swewalka/FIRST-Space-Team-project/launch-checklist.md

# Launch Checklist

## 1. Assembly

| Done | Index | Task | Tools / Materials |
|:---:|:---:|---|---|
| [ ] | 1.1 | Mount upper and lower rail buttons | 2x M3x10 screws, Torx key set |
| [ ] | 1.2 | Mount flight computer onto electronics mount | 2x M3x8 screws, Torx key set |
| [ ] | 1.3 | Mount battery onto electronics mount | Tape |
| [ ] | 1.4 | Mount RBF pin mechanism into electronics segment | — |
| [ ] | 1.5 | Mount electronics mount into E-Bay | 3x M3x8 screws, Torx key set |
| [ ] | 1.6 | Insert RBF safety pin | RBF pin |
| [ ] | 1.7 | Prepare payload: 3 eggs | 3 eggs |
| [ ] | 1.8 | Put dampening foam into cone | Dampening foam |
| [ ] | 1.9 | Insert payload into cone | — |
| [ ] | 1.10 | Make sure payload sits tight | — |
| [ ] | 1.11 | Mount nose cone | — |
| [ ] | 1.12 | Connect lower body tube with friction coupler | — |
| [ ] | 1.13 | Check and, if necessary, fix friction fit | Tape |
| [ ] | 1.14 | Screw in boat tail and check for fit | — |

## 2. Launch Preparation

| Done | Index | Task | Tools / Materials |
|:---:|:---:|---|---|
| [ ] | 2.1 | Make sure all rocket parts are properly assembled | — |
| [ ] | 2.2 | Remove electronics mount | Torx key set |
| [ ] | 2.3 | Connect flight computer to battery | — |
| [ ] | 2.4 | Verify flight computer functionality | — |
| [ ] | 2.5 | Notify launch officers and wait for preparation of black powder charge | — |
| [ ] | 2.6 | Mount electronics mount into E-Bay | 3x M3x10 screws, Torx key set |
| [ ] | 2.7 | Insert RBF safety pin and verify it is fully seated | RBF pin |
| [ ] | 2.8 | Connect black powder charge to flight computer with RBF safety pin inserted | — |
| [ ] | 2.9 | Wrap parachute in Kevlar cloth | — |
| [ ] | 2.10 | Put parachute and black powder charge into recovery compartment | — |
| [ ] | 2.11 | Verify that the parachute does not get stuck in the rocket | — |
| [ ] | 2.12 | Wait for motor preparation | — |
| [ ] | 2.13 | Insert motor into motor tube | — |
| [ ] | 2.14 | Screw boat tail on | — |
| [ ] | 2.15 | Check the rocket for any obvious faults | — |
| [ ] | 2.16 | Notify launch officers that the rocket is ready for launch | — |

## 3. Launch Pad

| Done | Index | Task | Tools / Materials |
|:---:|:---:|---|---|
| [ ] | 3.1 | Remove RBF safety pin to power on flight computer | RBF pin |
