swewalka/FIRST-Space-Team-project/3d models/CNCKitchen_Inserts_2025-07/STEP/14-20.step

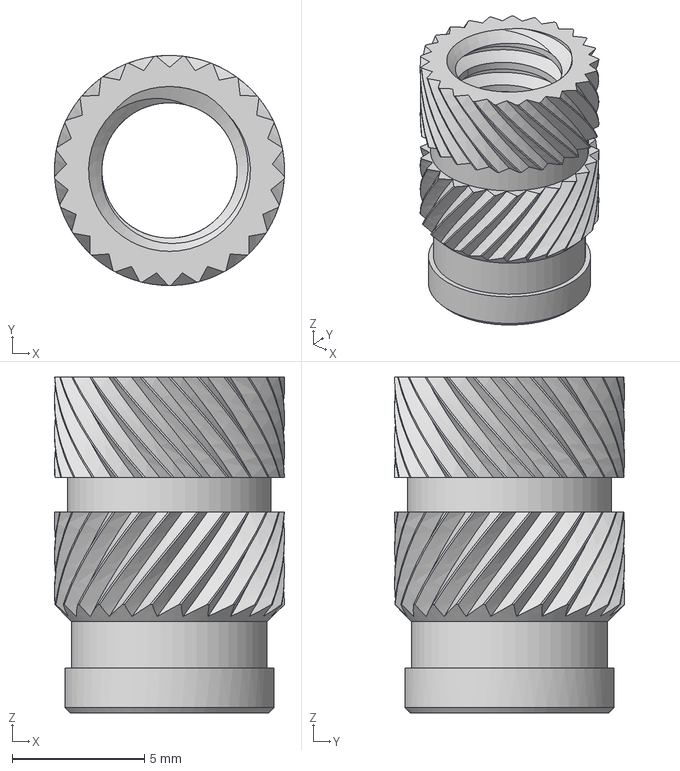
[picture p1: CAD file, 2026-10-09]
3d models/CNCKitchen_Inserts_2025-07/STEP/14-20.step
8.70 x 8.70 x 12.7 mm
