swewalka/FIRST-Space-Team-project/3d models/CNCKitchen_Inserts_2025-07/STL/m3_standard.stl

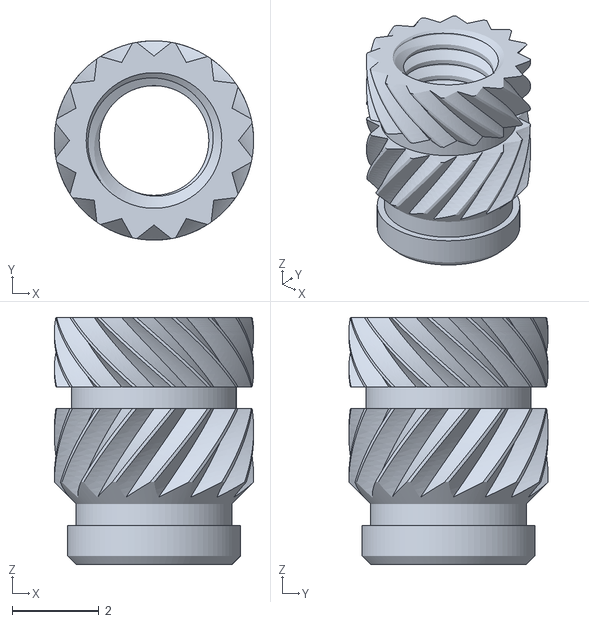
[picture p2: CAD file, 2026-10-09]
3d models/CNCKitchen_Inserts_2025-07/STL/m3_standard.stl
4.60 x 4.60 x 5.70
