swewalka/FIRST-Space-Team-project/3d models/RBF Pin.step

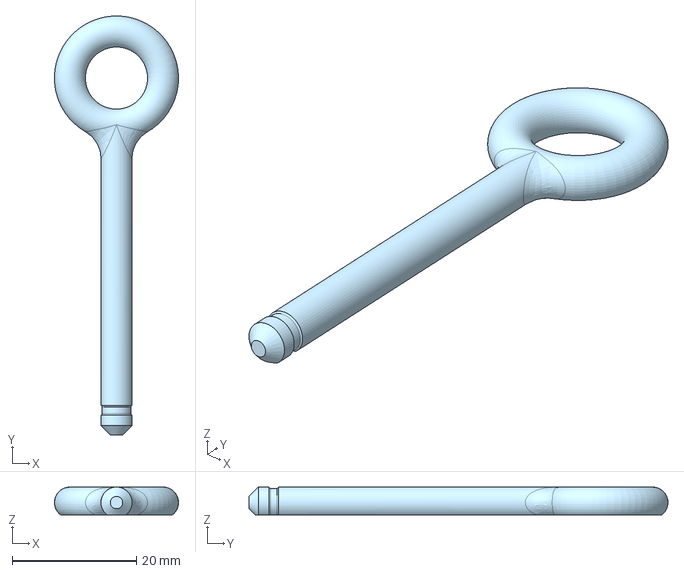
[picture p3: CAD file, 2026-11-08]
3d models/RBF Pin.step
20.0 x 67.5 x 4.50 mm
