swewalka/FIRST-Space-Team-project/3d models/Avionics Plate V3.step

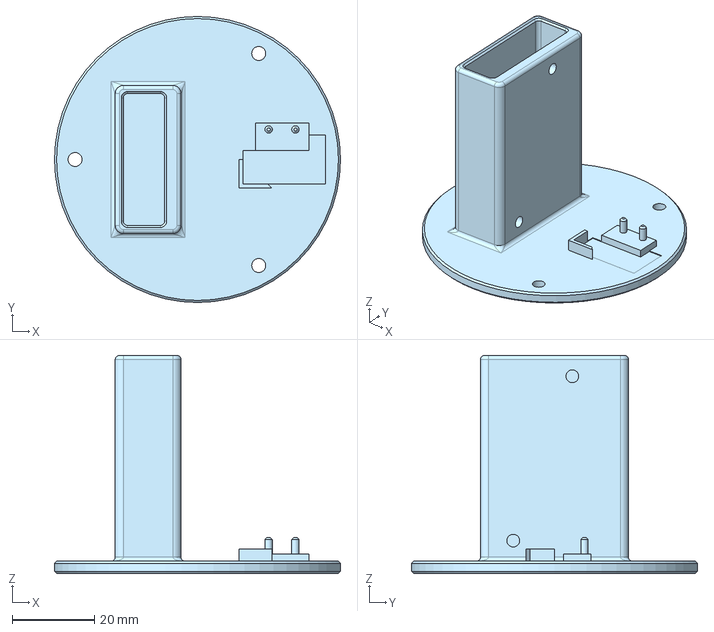
[picture p4: CAD file, 2026-11-08]
3d models/Avionics Plate V3.step
69.5 x 69.5 x 53.0 mm
