swewalka/FIRST-Space-Team-project/3d models/CNCKitchen_Inserts_2025-07/STEP/m4_short.step

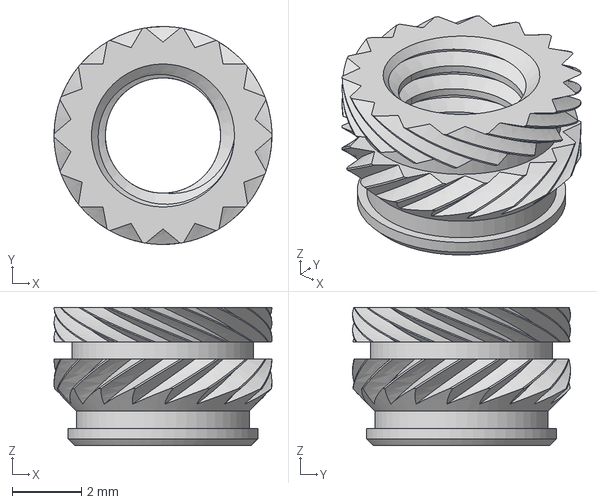
[picture p5: CAD file, 2026-10-09]
3d models/CNCKitchen_Inserts_2025-07/STEP/m4_short.step
6.30 x 6.30 x 4.00 mm
