swewalka/FIRST-Space-Team-project/3d models/CNCKitchen_Inserts_2025-07/STL/m4_standard.stl

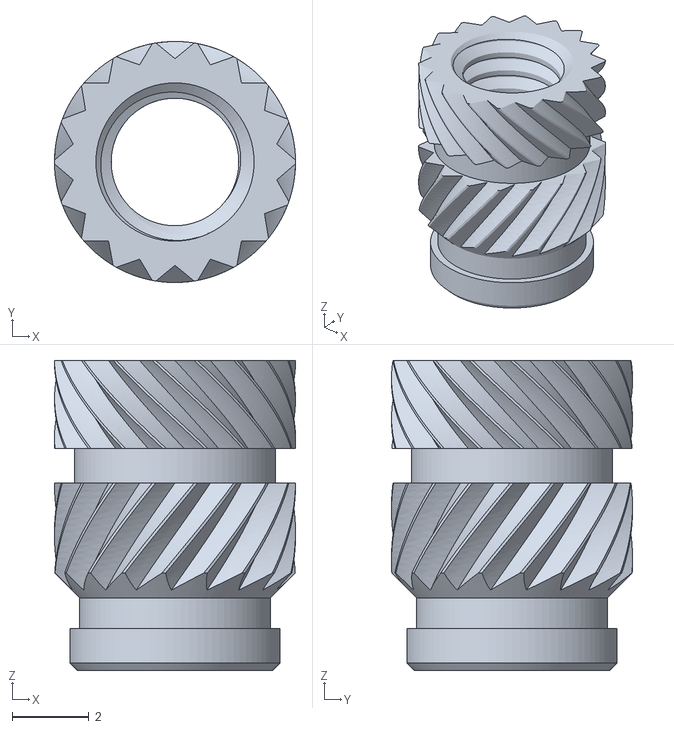
[picture p6: CAD file, 2026-10-09]
3d models/CNCKitchen_Inserts_2025-07/STL/m4_standard.stl
6.30 x 6.30 x 8.10
