swewalka/FIRST-Space-Team-project/3d models/CNCKitchen_Inserts_2025-07/STL/m3_short.stl

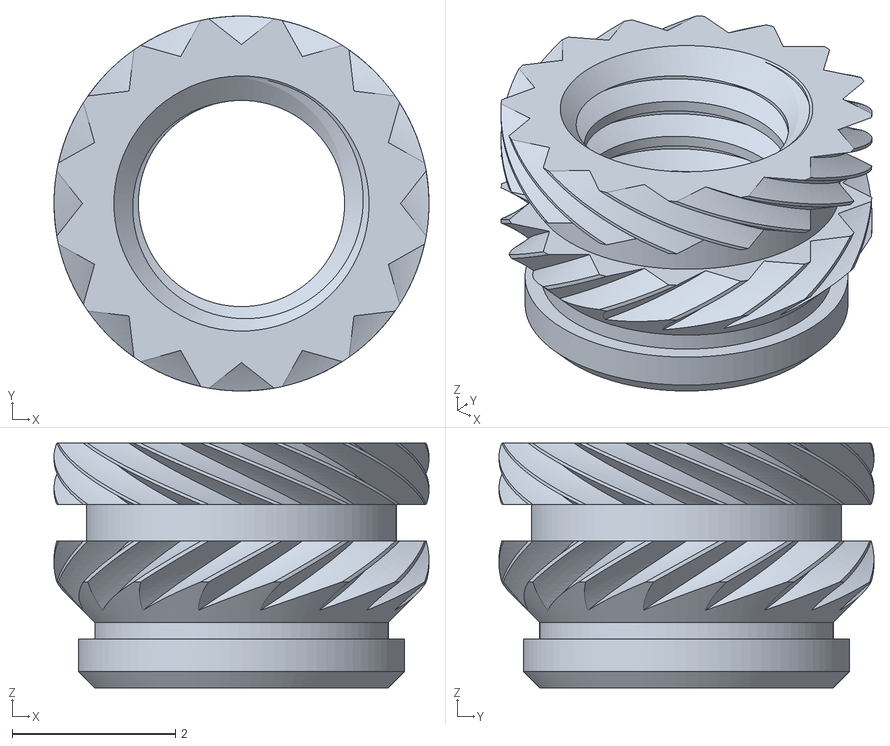
[picture p7: CAD file, 2026-10-09]
3d models/CNCKitchen_Inserts_2025-07/STL/m3_short.stl
4.60 x 4.60 x 3.00
