swewalka/FIRST-Space-Team-project/3d models/RBF Box.step

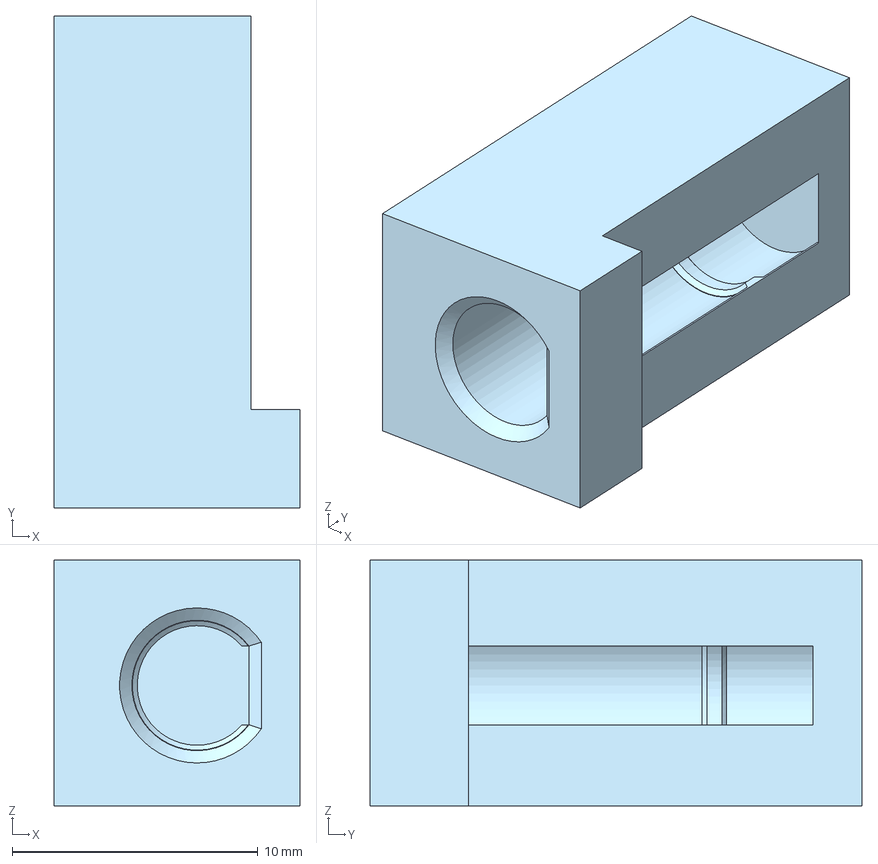
[picture p8: CAD file, 2026-11-08]
3d models/RBF Box.step
10.0 x 20.0 x 10.0 mm
