swewalka/FIRST-Space-Team-project/3d models/CNCKitchen_Inserts_2025-07/STEP/m2p5_short.step

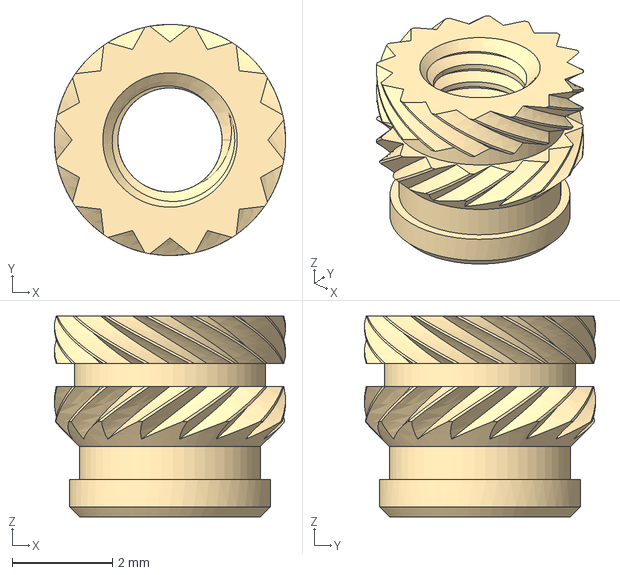
[picture p9: CAD file, 2026-10-09]
3d models/CNCKitchen_Inserts_2025-07/STEP/m2p5_short.step
4.60 x 4.60 x 4.00 mm
