swewalka/FIRST-Space-Team-project/3d models/Fin Can.step

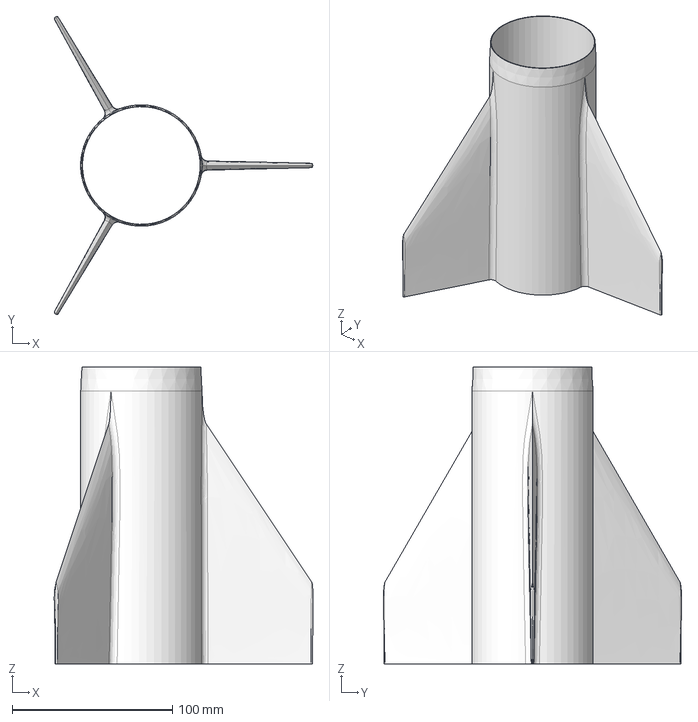
[picture p10: CAD file, 2026-11-08]
3d models/Fin Can.step
161.1 x 185.7 x 185.0 mm
