swewalka/FIRST-Space-Team-project/3d models/CNCKitchen_Inserts_2025-07/STEP/m5_short.step

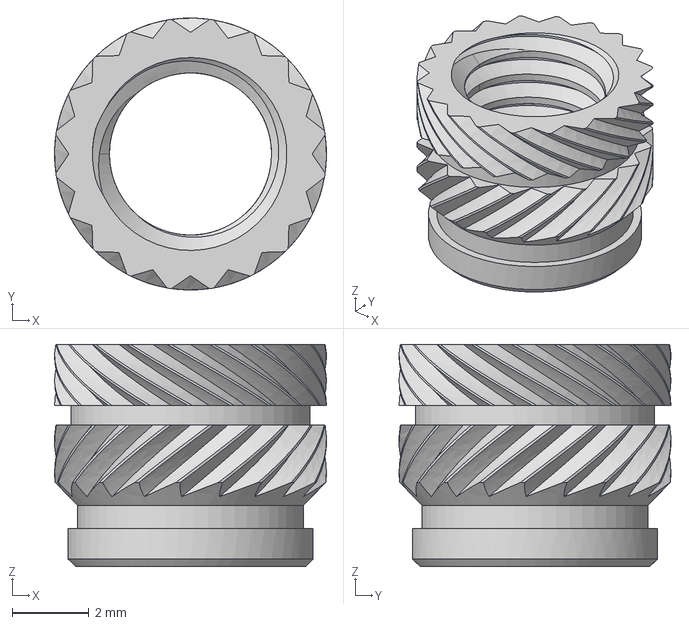
[picture p11: CAD file, 2026-10-09]
3d models/CNCKitchen_Inserts_2025-07/STEP/m5_short.step
7.10 x 7.10 x 5.80 mm
