swewalka/FIRST-Space-Team-project/3d models/Lower Attachment Ring.step

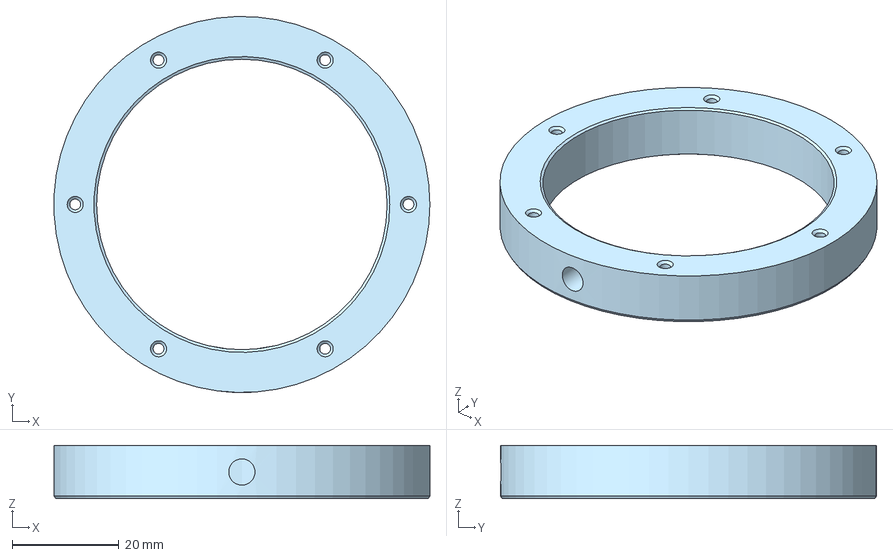
[picture p12: CAD file, 2026-11-08]
3d models/Lower Attachment Ring.step
70.3 x 70.3 x 10.0 mm
