swewalka/FIRST-Space-Team-project/3d models/CNCKitchen_Inserts_2025-07/STEP/g18-28_standard.step

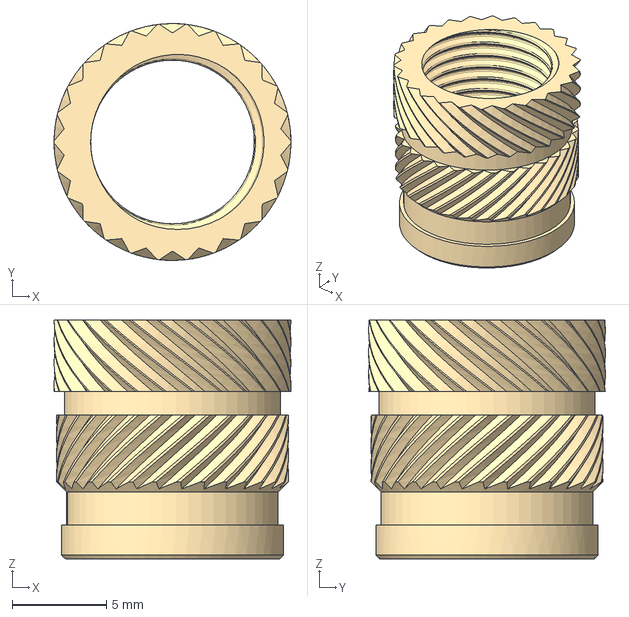
[picture p13: CAD file, 2026-10-09]
3d models/CNCKitchen_Inserts_2025-07/STEP/g18-28_standard.step
12.6 x 12.6 x 12.7 mm
