swewalka/FIRST-Space-Team-project/3d models/Upper Attachment Ring.step

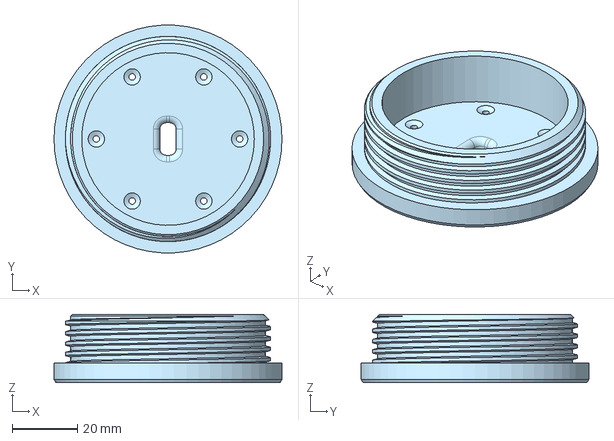
[picture p14: CAD file, 2026-11-08]
3d models/Upper Attachment Ring.step
70.0 x 69.9 x 21.0 mm
