swewalka/FIRST-Space-Team-project/3d models/Boat Tail Internal Thread.step

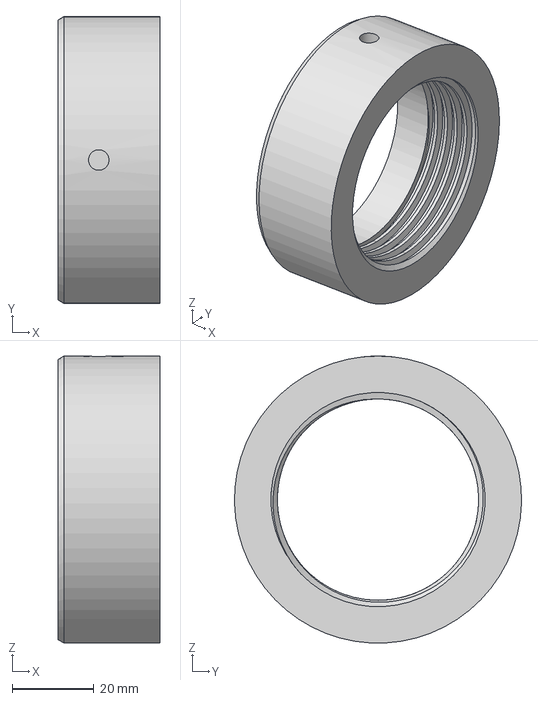
[picture p15: CAD file, 2026-11-08]
3d models/Boat Tail Internal Thread.step
25.0 x 70.1 x 70.1 mm
