swewalka/FIRST-Space-Team-project/3d models/CNCKitchen_Inserts_2025-07/STEP/m8_standard.step

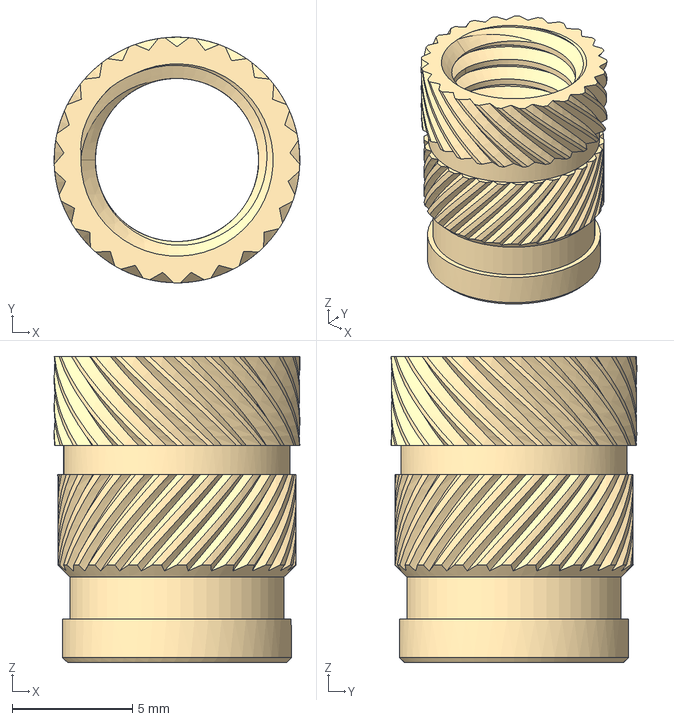
[picture p16: CAD file, 2026-10-09]
3d models/CNCKitchen_Inserts_2025-07/STEP/m8_standard.step
10.2 x 10.2 x 12.7 mm
