swewalka/FIRST-Space-Team-project/3d models/Boat Tail External Thread.step

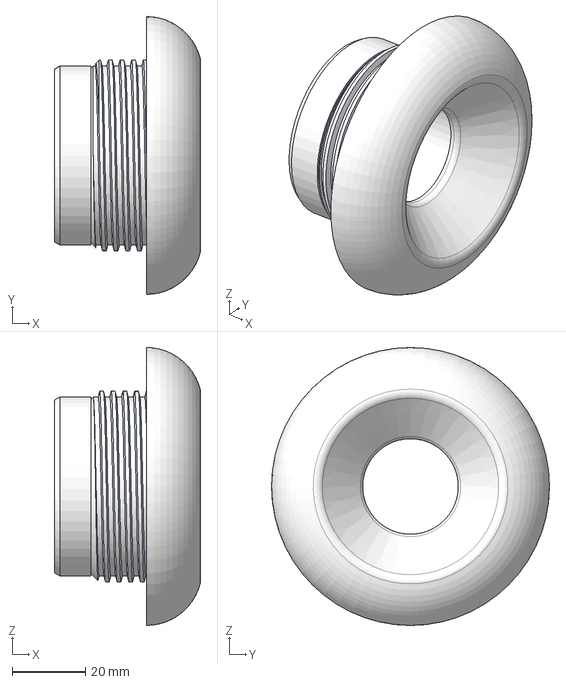
[picture p17: CAD file, 2026-11-08]
3d models/Boat Tail External Thread.step
39.8 x 75.7 x 75.7 mm
