swewalka/FIRST-Space-Team-project/3d models/CNCKitchen_Inserts_2025-07/STEP/m5_standard.step

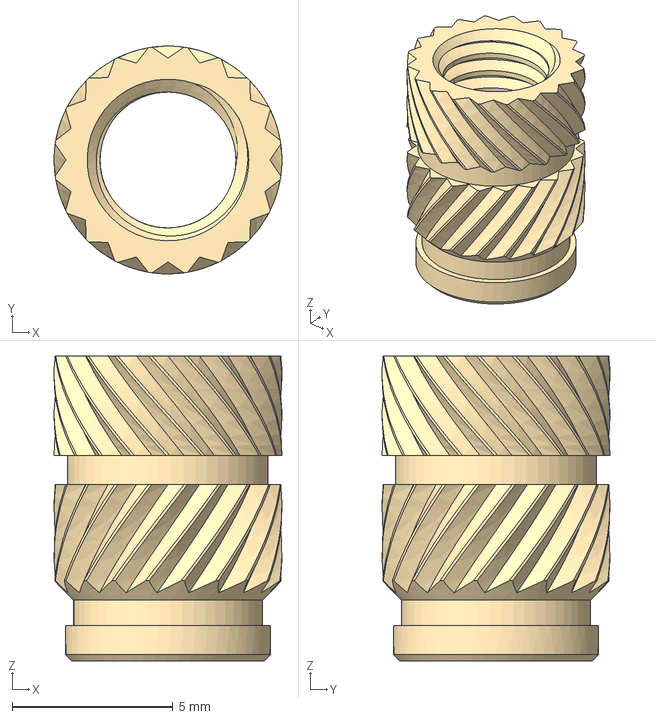
[picture p18: CAD file, 2026-10-09]
3d models/CNCKitchen_Inserts_2025-07/STEP/m5_standard.step
7.10 x 7.10 x 9.50 mm
