swewalka/FIRST-Space-Team-project/3d models/Elliptical Cone.step

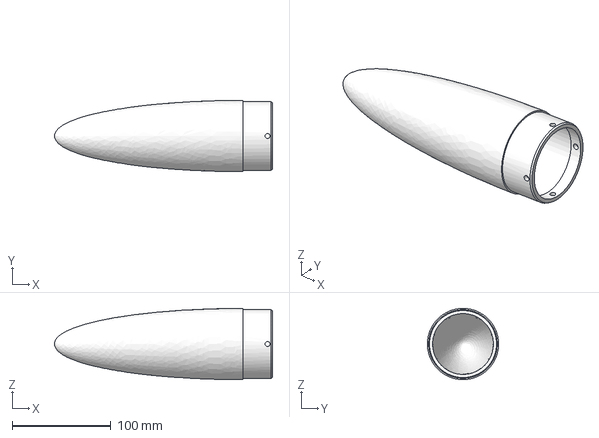
[picture p19: CAD file, 2026-11-08]
3d models/Elliptical Cone.step
221.3 x 72.4 x 72.4 mm
