swewalka/FIRST-Space-Team-project/3d models/Print File.3mf

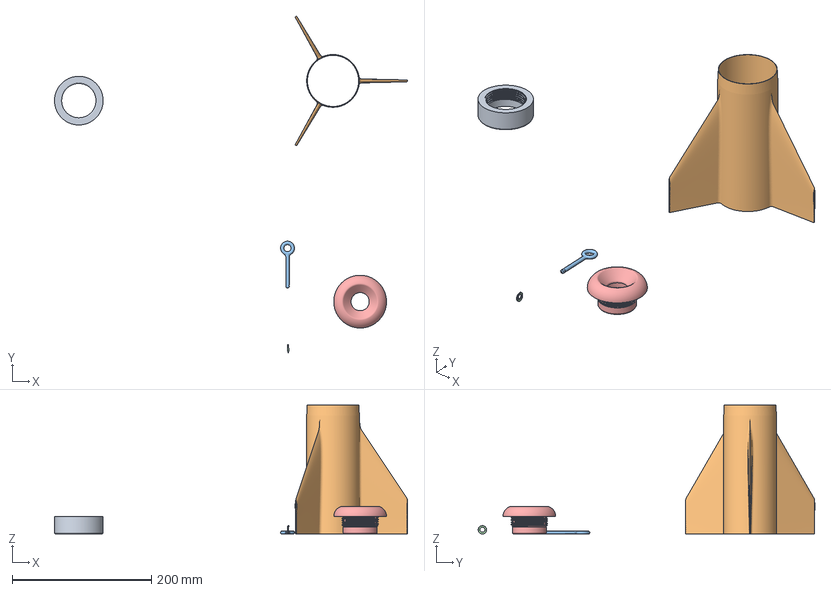
[picture p20: CAD file, 2026-11-08]
3d models/Print File.3mf
506.5 x 483.0 x 185.0 mm
Boat Tail - innengewinde.step
Fin_Can_1 - fin_tube.step
RBF Pin - RBF Pin.step
safety pin slot.step
Boat Tail - außengewinde.step
