swewalka/FIRST-Space-Team-project/3d models/Safety Pin Slot.step

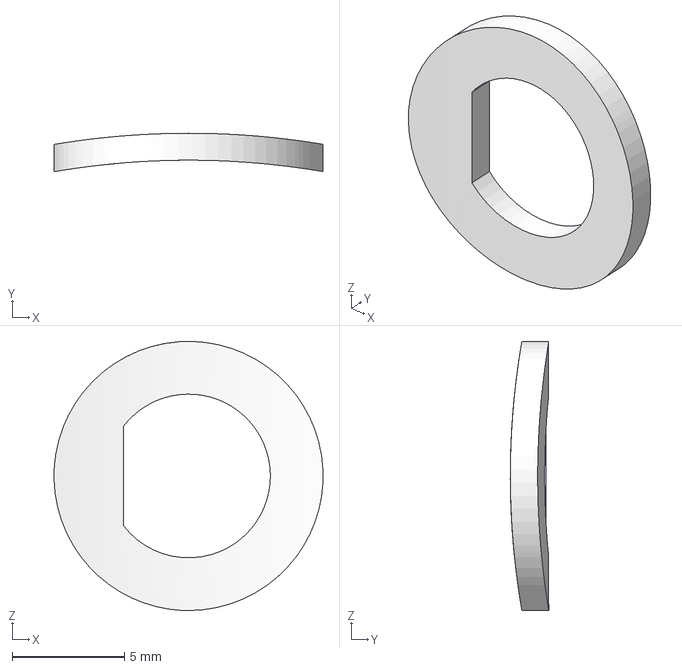
[picture p21: CAD file, 2026-11-08]
3d models/Safety Pin Slot.step
12.0 x 1.72 x 12.0 mm
