swewalka/FIRST-Space-Team-project/3d models/Coupler Tube V3.step

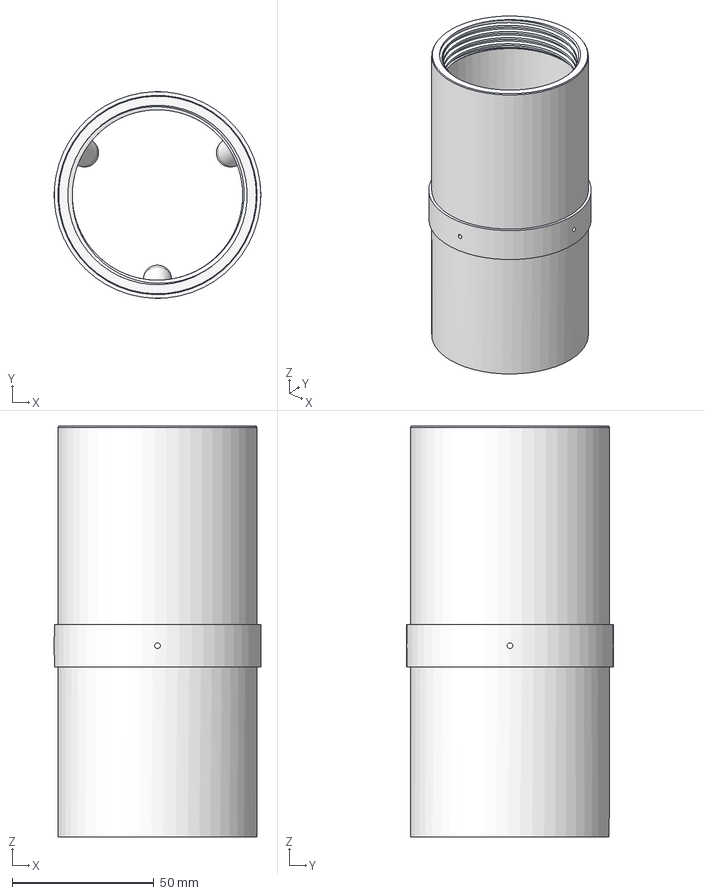
[picture p22: CAD file, 2026-11-08]
3d models/Coupler Tube V3.step
72.9 x 72.9 x 145.0 mm
