swewalka/FIRST-Space-Team-project/3d models/Drill Guide 4mm.step

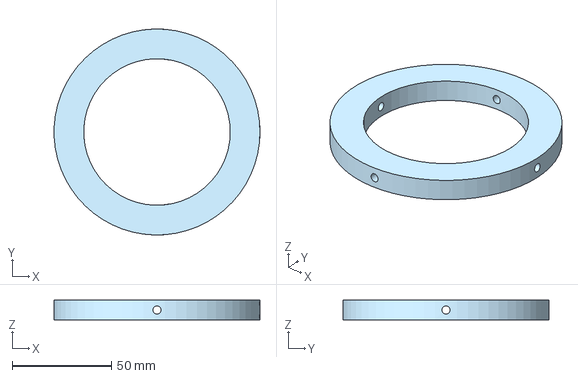
[picture p23: CAD file, 2026-11-08]
3d models/Drill Guide 4mm.step
103.9 x 103.9 x 10.0 mm
