swewalka/FIRST-Space-Team-project/3d models/RBF Box - RBF Box.step

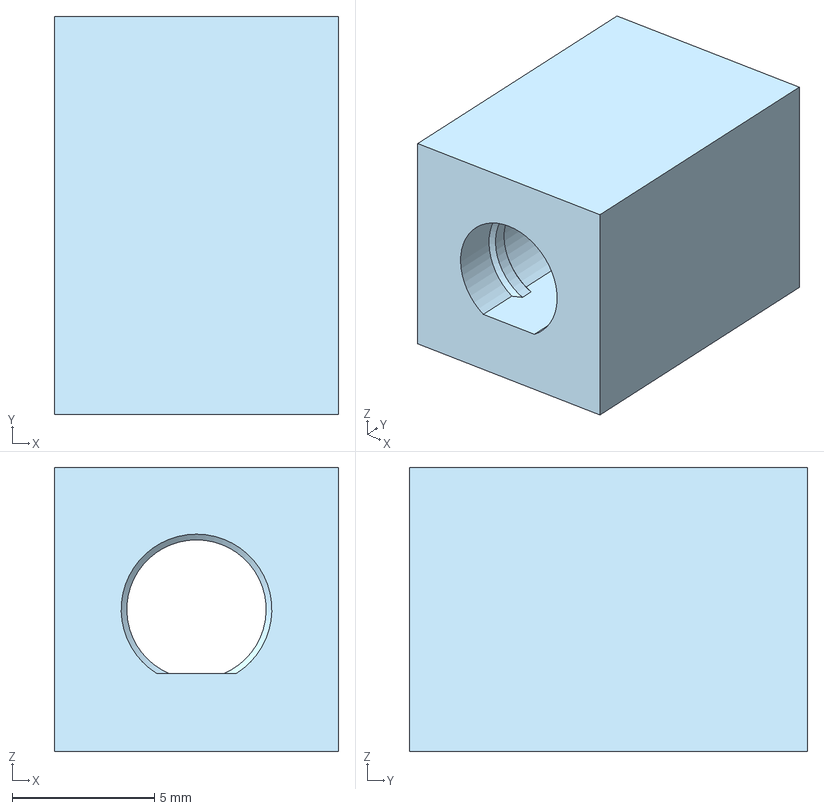
[picture p24: CAD file, 2026-10-09]
3d models/RBF Box - RBF Box.step
10.0 x 14.0 x 10.0 mm
