swewalka/FIRST-Space-Team-project/3d models/Coupler_Tube_V2 - Coupler_Tube.step

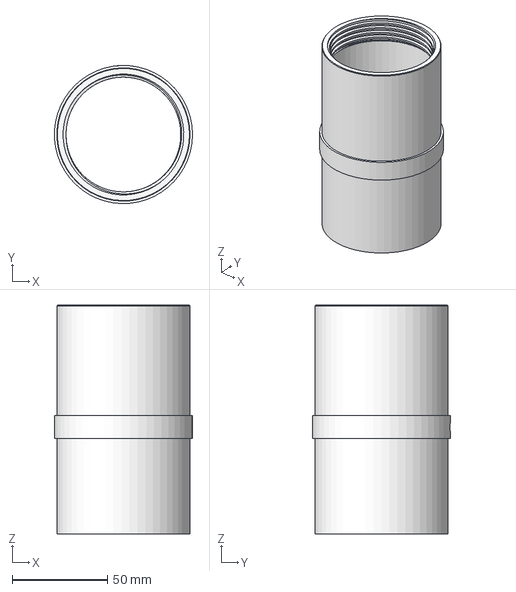
[picture p25: CAD file, 2026-10-09]
3d models/Coupler_Tube_V2 - Coupler_Tube.step
72.3 x 72.4 x 120.0 mm
