swewalka/FIRST-Space-Team-project/3d models/RBF Pin - RBF Pin.step

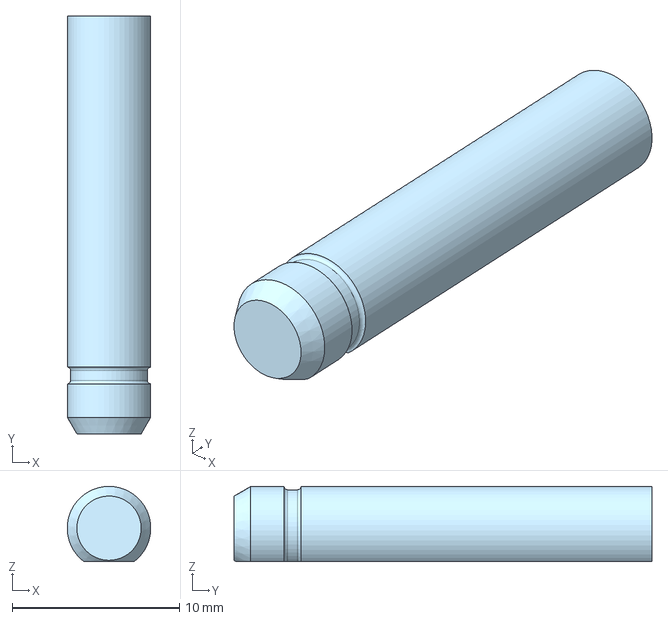
[picture p26: CAD file, 2026-10-09]
3d models/RBF Pin - RBF Pin.step
4.99 x 25.0 x 4.50 mm
