swewalka/FIRST-Space-Team-project/3d models/Avionics_Plate_V2 - Aviontics Plate.step

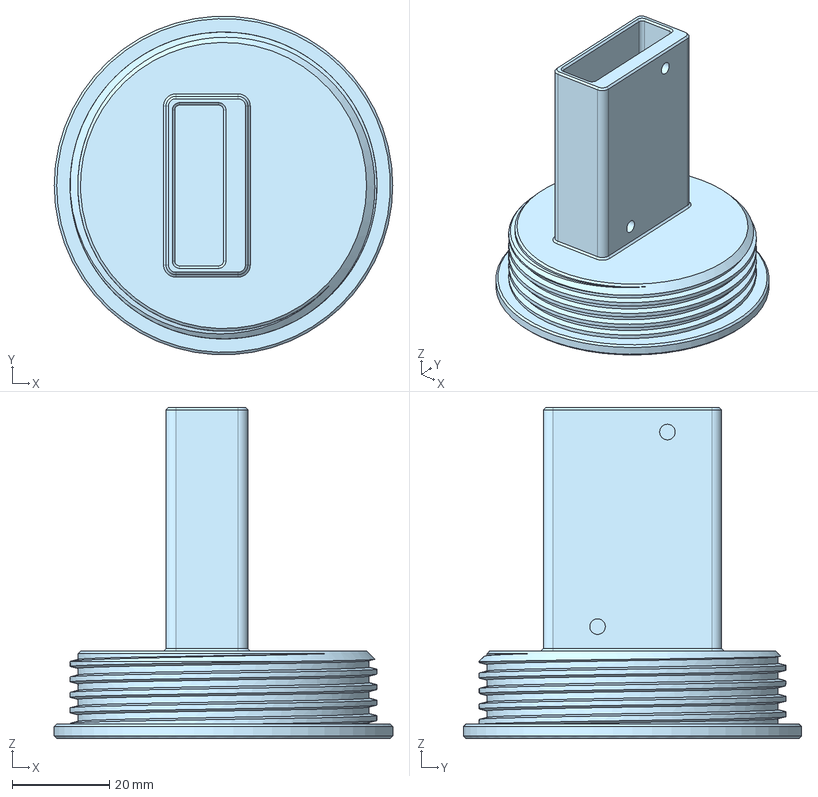
[picture p27: CAD file, 2026-10-09]
3d models/Avionics_Plate_V2 - Aviontics Plate.step
69.5 x 69.4 x 68.0 mm
