swewalka/FIRST-Space-Team-project/(list of files, cad)

Other CAD files:
3d models/CNCKitchen_Inserts_2025-07/STEP/m6_standard.step
3d models/CNCKitchen_Inserts_2025-07/STL/14-20_standard.stl
3d models/CNCKitchen_Inserts_2025-07/STEP/m10_standard.step
3d models/Fin_Can_1 - fin_tube.step
3d models/Boat Tail - außengewinde.step
3d models/Boat Tail - innengewinde.step
3d models/Boat Tail - innengewinde.3mf
3d models/CNCKitchen_Inserts_2025-07/STL/g18-28_standard.stl
3d models/CNCKitchen_Inserts_2025-07/STL/m10_standard.stl
3d models/CNCKitchen_Inserts_2025-07/STL/m2p5_short.stl
3d models/CNCKitchen_Inserts_2025-07/STL/m4_short.stl
3d models/CNCKitchen_Inserts_2025-07/STL/m5_short.stl
3d models/CNCKitchen_Inserts_2025-07/STL/m5_standard.stl
3d models/CNCKitchen_Inserts_2025-07/STL/m6_standard.stl
3d models/CNCKitchen_Inserts_2025-07/STL/m8_standard.stl
3d models/RBF Pin - v2.step
3d models/printfile.3mf
