swewalka/FIRST-Space-Team-project/guidelines/how-to-rocketry-UoF.pdf

Link to workshops from previous FIRST seasons: https://youtube.com/playlist?list=PLF_iJ5FHlMIT2lomy2YwLGfMxNMTDnl-G

1Fins

1.1Use fillets at edges between bodytube and fins
1.2When slotting fins into the bodytube, do not cut the bodytube all the way to the end -this leads to structural weaknesses
1.3Be careful when fins protrude behind the bodytube - this can cause fins to break upon ground impact. Fins can be designed as replaceable to avoid this issue. 1.4Aerodynamic stability can be increased with spin, although it's not very usual due to the increased manufacturing complexity.
2Motor mount

2.1The motor casing has to be easily integrable and removable from the rocket.

# How to Rocketry

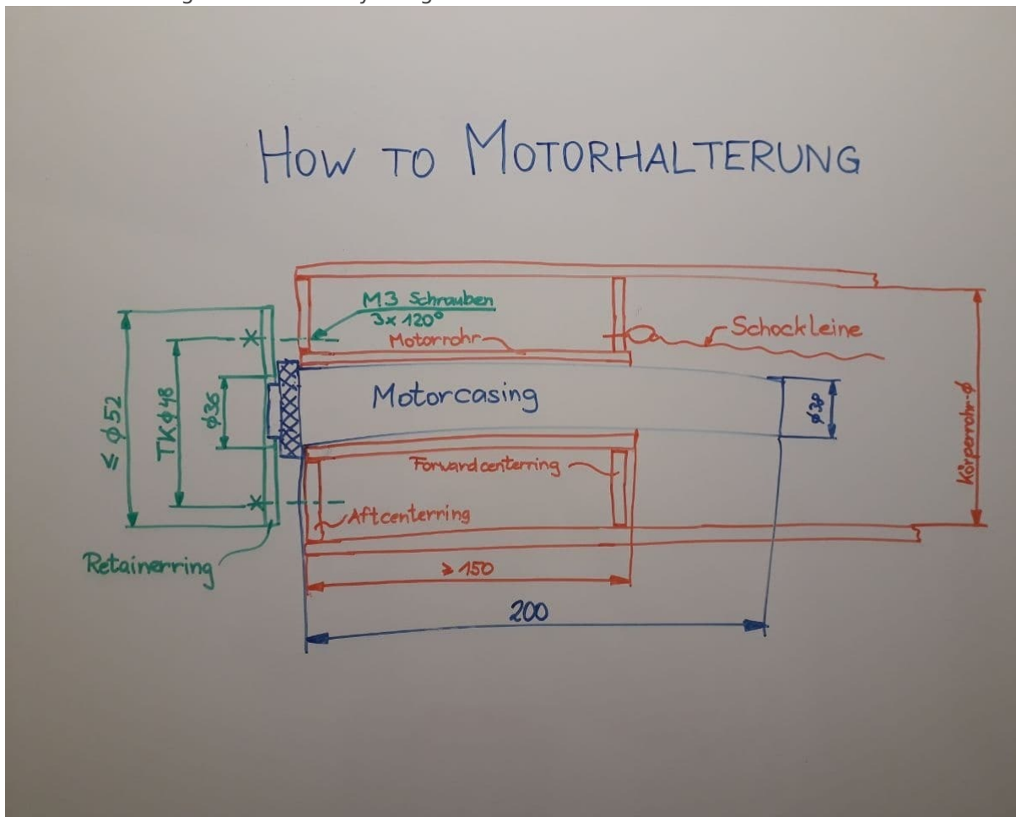
[picture p28: figure]

2.2The motor casing has to be held inside the motor tube, usually with a retainer ring or a threaded tailcone.
2.3Make sure that no screws or retainer parts protrude unnecessarily far behind the body tube.
2.4Nomenklatur:

2.4.1Grain: solid fuel/oxidator mixture, that gets burned and prodruces the thrust 2.4.2Reload: consists of grains and other single use parts, that can be bought as a package (e.g. Aerotech H2389T)
2.4.3Motorcasing: reusable metal casing that holds the grain - it's classified by their diamter and length in millimeters (e.g. 29/180)
2.4.4Motorrohr/Motorhalter: tube (often cardboard) that is fixed inside the back of the rocket, in which the motor casing can be inserted and fixed
2.4.5Adapter: can be used to put smaller motor casings into motor mounts with a larger diameter, e.g. using a 29 mm motor casing in a 38 mm motor mount 2.4.6Retainer: hold the motor casing inside the motor tube
2.4.7Spacer: allows using casings, that would normally require a more powerful motor, with a smaller one by replacing grains with spacers
3Motor

3.1We usually use a Aerotech H-238T with a RMS-29/180 casing or a RMS-29/240 casing with one spacer. The image shows a section cut of an Aerotech H220T motor.

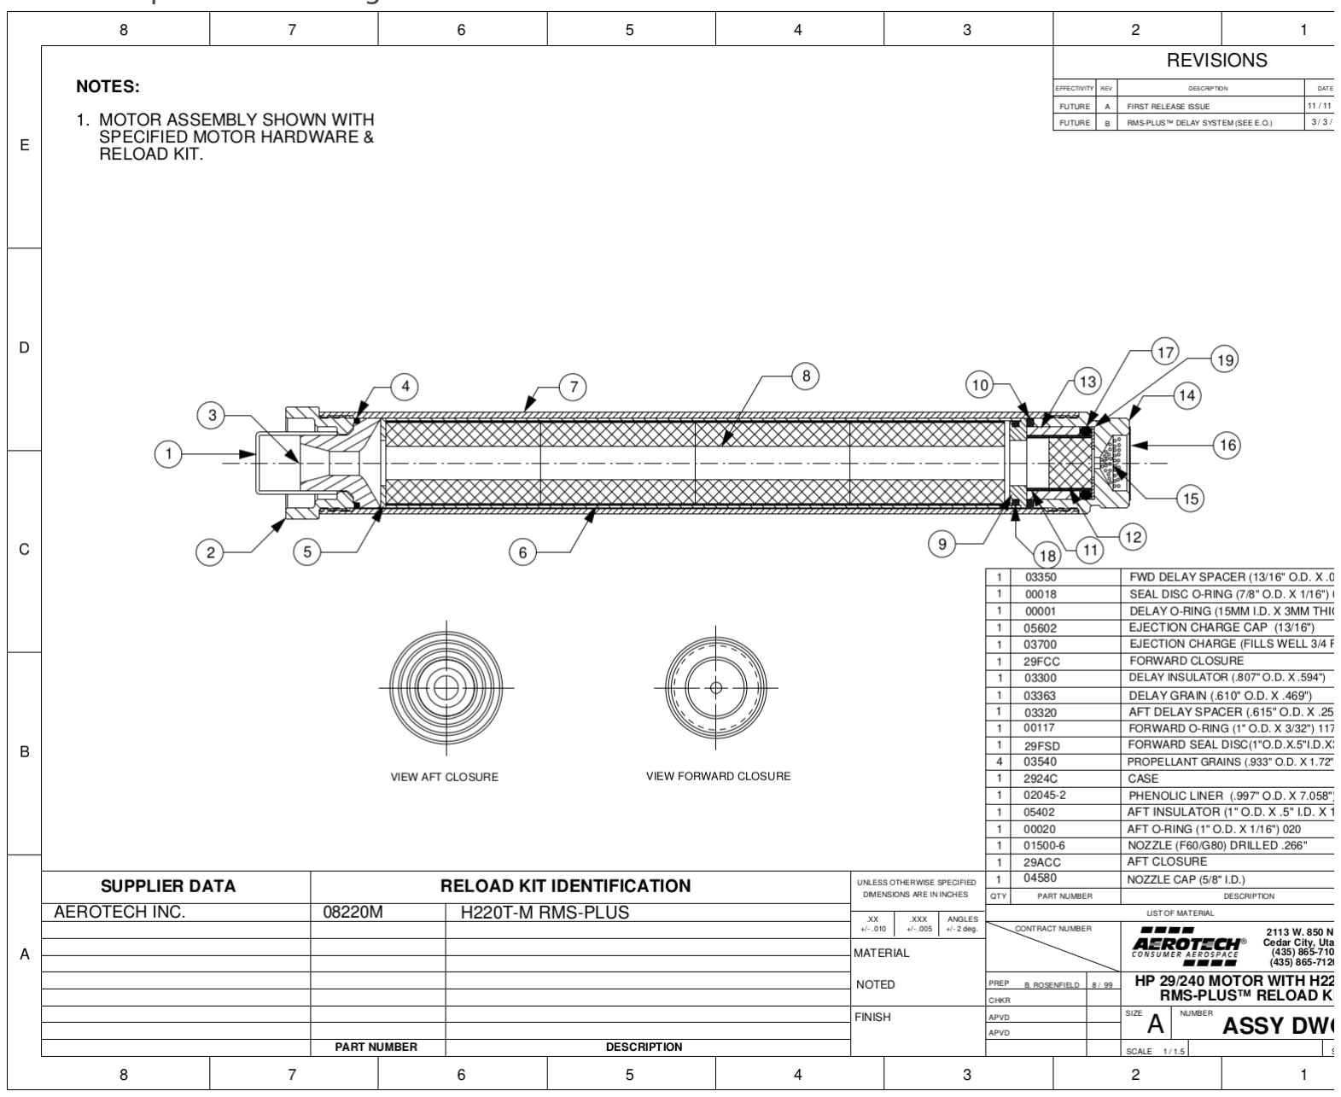
[picture p29: figure]

4Railbuttons

4.1one should be placed far back on the rocket, so that the rockets remains guided in the launch rail for as long as possible, while the other one should be located around the rocket's center of mass
4.2if the railbuttons are placed on seperate body tube segments, they should be designed to prevent rotation between the two bodytube segments
4.3the mount of the railbuttons on the inside of the rocket must not obstruct the parachute from deploying
4.4measurements of the railbutton:

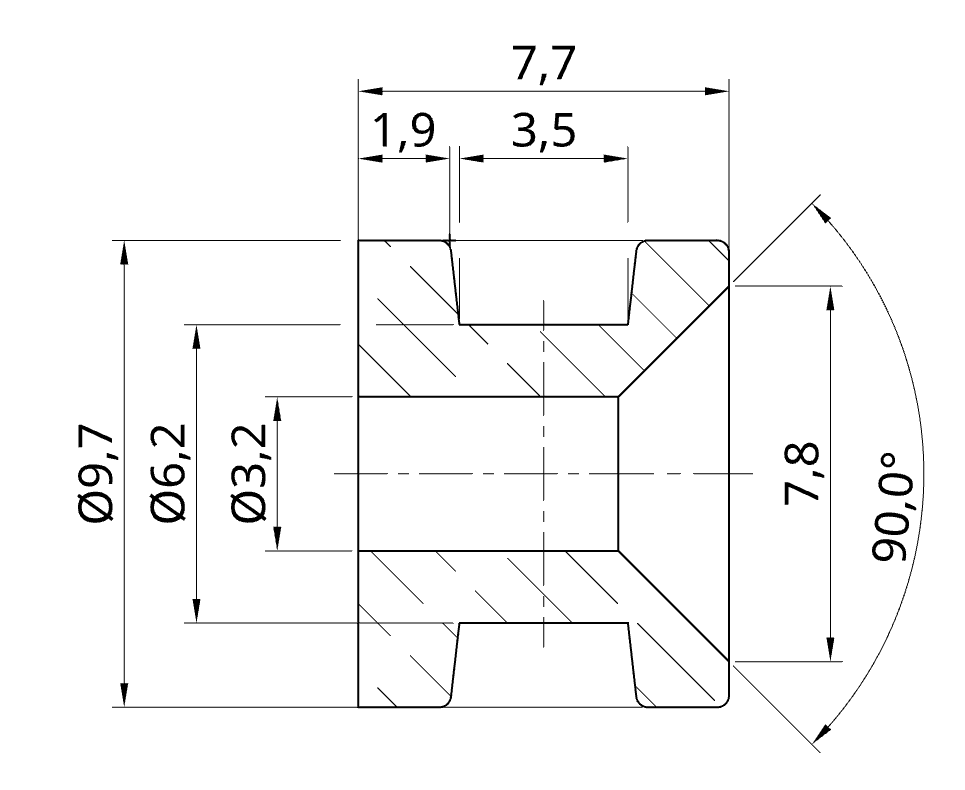
[picture p30: figure]

5Flight computer

5.1The flight computer detects the apogee (highest point of the flight) and ignites a black powder charge inside the bodytube. The created pressure forces the rocket segments to seperate, allowing the parachute to slip out of the bodytube.
5.2The height measurements works with a barometric sensor, therefore the flight computer requires some holes (at least two 2 mm holes at oppositbe sides of the bodytube) to allow it to detect the outside pressure. These holes have to be radial to the rocket's axis, so that the sensor only measure static pressure and not dynamic pressure from the "wind" of the air in the rocket's path.
5.3The flight computer has to be protected from the hot gas created by the blackpowder.
5.4muss im zusammengebauten Zustand auf der Startrampe scharf gemacht und entschärft werden können (RBF Pin, Schalter) The flight computer has to be able to be armed and disarmed after the rocket has been inserted into the launch rail with the use of a switch or RBF (remove before flight) pin.
6Radio transmission

6.1If the rocket has to communicate with the ground in any way, be aware that carbon fiber is conductive - use glass fiber for such segments instead.
7Parachute

7.1Has to easily slip out of the rocket - if the rocket is turned upside down, it should slip out without require any shaking.

7.2Use slim Kevlar lines to connect the parachute, they are very heat resistant to survive the hot black powder gases.
7.3If the parachute main line should be removable, fix shorter lines into the rocket where the parachute main line can be connected with a carabiner.
7.4Leine am Körperrohrende wird üblicherweise am Centerring der Motorhalterung fixiert. Sie ist eher lang (~3-5 m), damit die Rakete nicht zu sehr taumelt und sich die Leine beim Öffnen des Fallschirms mehr dehnen kann. Die plötzliche Öffnung erzeugt nämlich einen Schock, der das Seil, den Ankerpunkt oder das Körperrohr beschädigen können. An der Stelle, an der die Leine das Körperrohr bei der Trennstelle berührt, kann mit Kreppband verdickt werden, damit die Kraft der Leine verteilt wird. Das Kreppband kommt auf die Leine, nicht das Rohr. The parachute's main line is usually fixed on one of the motor tubes centering rings and is about 3-5 m long. To avoid the parachute line cutting into the bodytube due to the shock of the parachtue deployment, this section of the bodytube can be supported with crepe tape.
7.5The parachute is not exerted by the blackpowder charge but due to the relative speed between the rocket's segments.
7.6The parachute line of the nosecone can be shorter (~1 m).
7.7The rocket also has some drag when descending, which is not considered by dimensiong software. Therefore the actual parachute may be slightly smaller than the calculated size.
7.8Ideally, the rocket should be aerodynamically instable after seperation, leading it to tumble and the parachute to deploy more easily.
8Seperation point

8.1The coupler's shoulder length (i.e. length inside the rocket part that gets removed at seperation) has to be at least one caliber (caliber = bodytube diameter)!!!
8.2Test for the friction coupler: when holding the lighter section of the rocket, the rocket should not seperate. With some shaking, the friction coupler should loosen and seperate. The strength of the friction coupler can be adjusted with crepe tape, for example.
8.3Be aware that the strength of the friction coupler can change due to environmental influence. For example, on a cold launch day, the friction coupler will be looser. 9Blackpowder charge

9.1small plastic capsule with an e-match, usually lies in the rocket without fixation 9.2has to be in the same pressure hull as the motor's back delay charge
9.3has to be wired to the flight computer
9.4has to be seperated from the flight computer to not cause damage
10to speed up the preparations and reduce complications it is advised to

10.1make the flight omputer and battery easily replaceable
10.2allow an easy integration and removal of the motor
10.3make the parachute and parachute lins easily replacable 11other tips

11.1stick to one type of screw (e.g. Torx M3)
11.2check out the safety code of the Tripoli (renowned association for high-power model

rocketry) - not mandatory but may be interesting: https://www.tripoli.org/safety

1Screws, thread inserts
2epoxy, superglue
3wooden plates, glass fiber (GFK) plates 4PLA, PC, ASA for 3D printing
5Aluminium (tube, cylinder, plate)
6GFK (carbon fiber)/CFK-prepreg for laminating 7cables

1laminating (wet, prepreg) 2CNC milling (wood, GFK)
3lathing (metals)
43D-printing (PLA, PC, ASA)
5"Dremeln", drilling (Danger: CFK, GFK-dust is toxic) 6Glueing(epoxy, super glue)
7sewing (sewing machine)
8splicing (parachute lines)
9spray paint
10foiling

# Common materials

# Manufacturing methods

Revision #5
Created 11 May 2026 08:10:25 by fabio.winkler@spaceteam.at Updated 11 May 2026 13:19:56 by fabio.winkler@spaceteam.at
