swewalka/FIRST-Space-Team-project/(commit log)

2026-09-13 adjusted sim to 70mm diameter
2026-11-08 Update launch checklist for RBF safety pin
